UAlberta-EcoCar/Fuel-Cell-Controller-2017-2018/Fuel_Cell_Controller.brd

## EAGLE design Fuel_Cell_Controller.brd (2018-07-14)

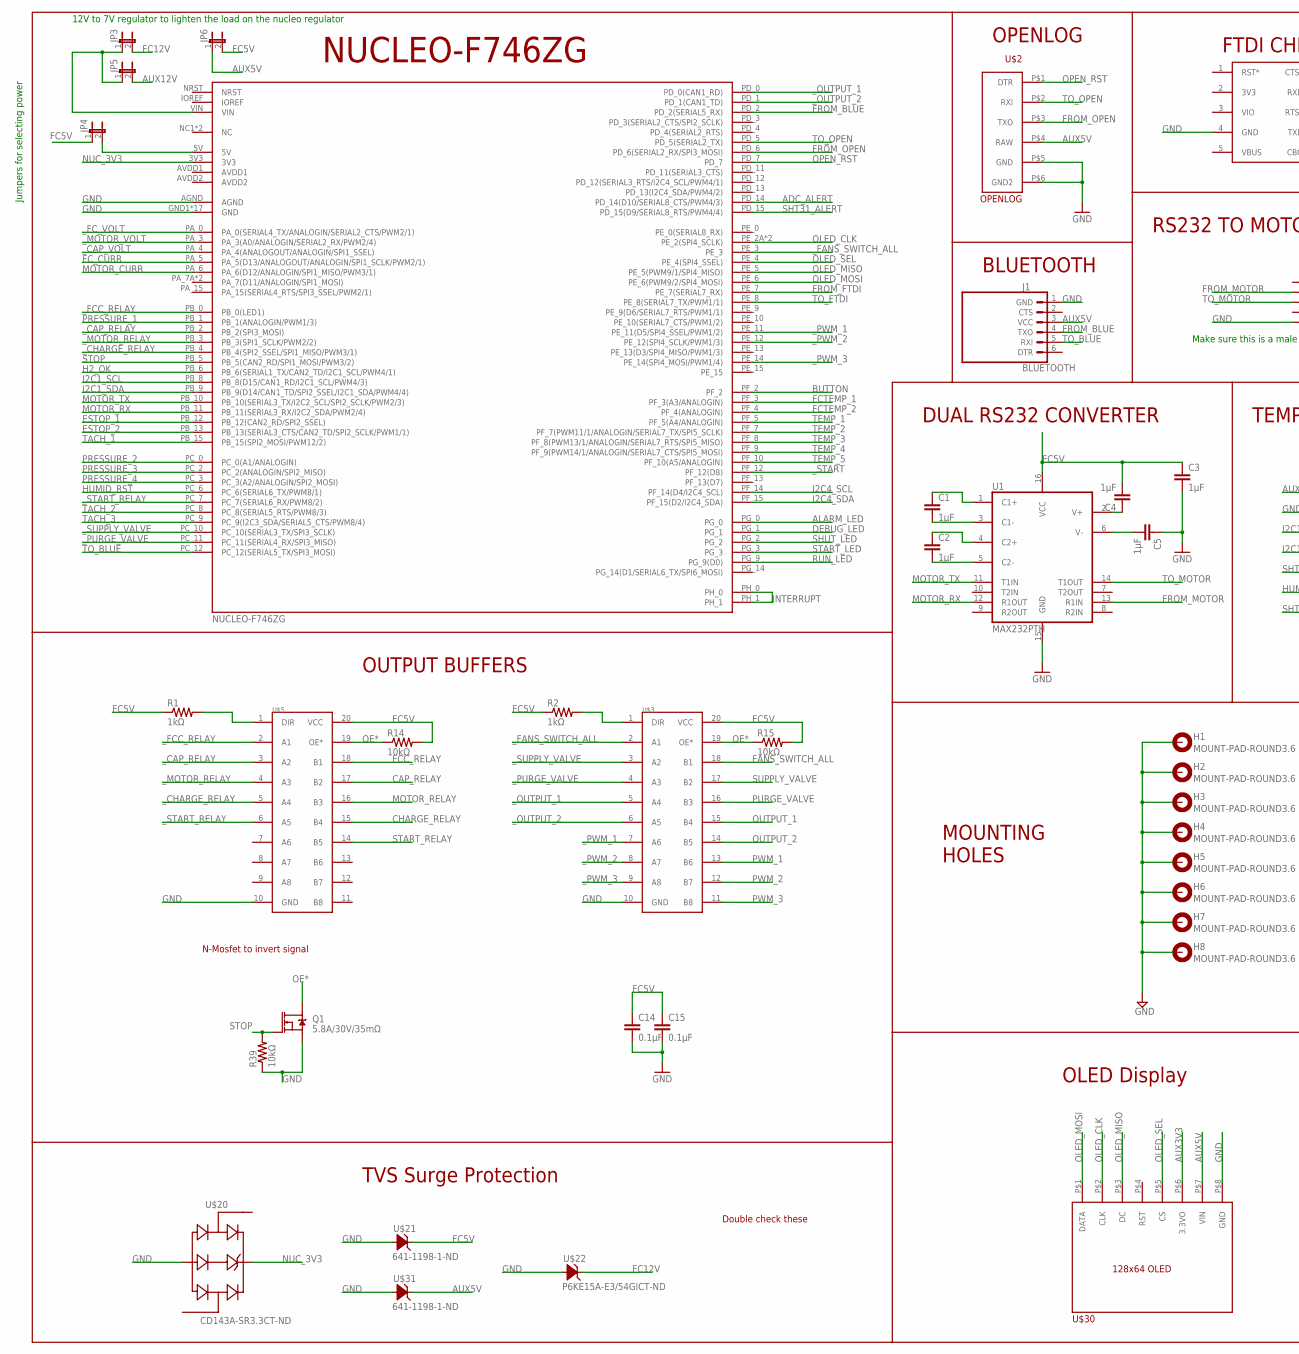
[picture p1: schematic Fuel_Cell_Controller.sch, sheet 1, MCU, part in row 1, column 1]

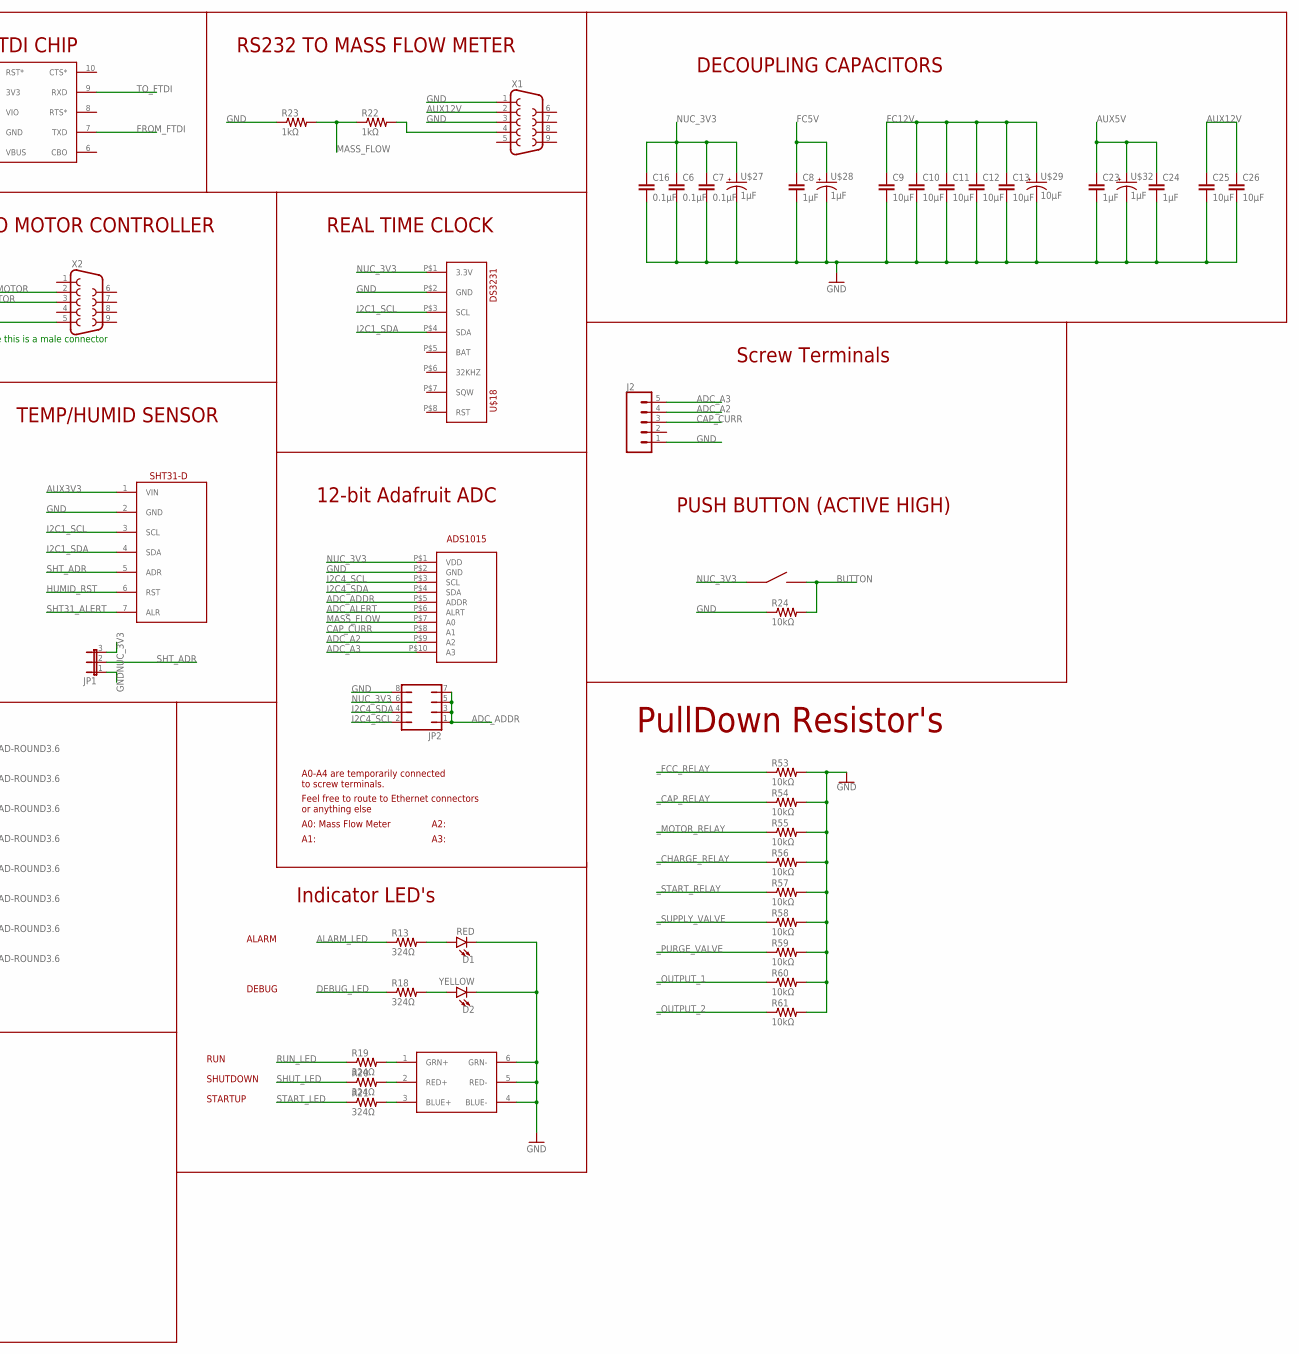
[picture p2: schematic Fuel_Cell_Controller.sch, sheet 1, MCU, part in row 1, column 2]

Parts:
C1, C2, C3, C4, C5, C8, C23, C24: 1µF; 0805
C6, C7, C14, C15, C16: 0.1µF; 0805
C9, C10, C11, C12, C13, C25, C26: 10µF; 0805
D1: RED; LED-1206
D2: YELLOW; LED-1206
H1, H2, H3, H4, H5, H6, H7, H8: MOUNT-PAD-ROUND3.6; 3,6-PAD
J1: BLUETOOTH; 1X06BLUETOOTH
J2: CONN_05SCREW; SCREWTERMINAL-3.5MM-5
JP1: JP2E; JP2
JP2: JP4Q
JP3, JP4, JP5, JP6: JP1E; JP1
Q1: 5.8A/30V/35mΩ; SOT23-3
R1, R2, R22, R23: 1kΩ; 0805
R13, R18, R19, R20, R21: 324Ω; 0805
R14, R15, R24, R39, R53, R54, R55, R56, R57, R58, R59, R60, R61: 10kΩ; 0805
SHTSENSOR: SHT31-DIS; 1X07-SHT31-DIS
U1: MAX232PTH; DIL16
U$1: NUCLEO-F746ZGNUCLEO-F746ZG; NUCLEO-F746ZG
U$2: OPENLOG
U$3, U$5: SN74LVC245AN; DIL20
U$10: UMFT234XF
U$18: DS3231
U$19: ADS1015
U$20: CD143A-SR3.3CT-ND; SOT143_AVAGO
U$21, U$31: 641-1198-1-ND; SOT23
U$22: P6KE15A-E3/54GICT-ND; DO-204AC
U$25: 5060BRG45060BRG4; 5060BRG4
U$26: EG4621CT-ND
U$27, U$28, U$32: 1µF; PANASONIC_D
U$29: 10µF; PANASONIC_D
U$30: ADAFRUITOLED; 1X08OLED
X1, X2: F09HP

Connections:
ADC_A2: J2.4, U$19.P$9 (A2)
ADC_A3: J2.5, U$19.P$10 (A3)
ADC_ADDR: JP2.1, JP2.3, JP2.5, JP2.7, U$19.P$5 (ADDR)
ADC_ALERT: U$1.PD_14 (PD_14(D10/SERIAL8_CTS/PWM4/3)), U$19.P$6 (ALRT)
ALARM_LED: R13.1, U$1.PG_0
AUX3V3: SHTSENSOR.1 (VIN), U$30.P$6 (3.3VO)
AUX5V: C23.1, C24.1, J1.3 (VCC), JP6.1, U$2.P$4 (RAW), U$30.P$7 (VIN), U$31.C, U$32.+; also elsewhere on the board
AUX12V: C25.1, C26.1, JP5.2, X1.2; also elsewhere on the board
BUTTON: R24.2, U$1.PF_2, U$26.P$3, U$26.P$4
CAP_CURR: J2.3, U$19.P$8 (A1); also elsewhere on the board
CAP_RELAY: U$5.17 (B2); also elsewhere on the board
CHARGE_RELAY: U$5.15 (B4); also elsewhere on the board
DEBUG_LED: R18.1, U$1.PG_1
ESTOP_1: U$1.PB_12 (PB_12(CAN2_RD/SPI2_SSEL)); also elsewhere on the board
ESTOP_2: U$1.PB_13 (PB_13(SERIAL3_CTS/CAN2_TD/SPI2_SCLK/PWM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); also elsewhere on the board
FANS_SWITCH_ALL: U$3.18 (B1); also elsewhere on the board
FC5V: C3.1, C4.2, C8.1, C14.1, C15.1, JP4.1, JP6.2, R1.1, R2.1, R14.2, R15.2, U1.16 (VCC), U$3.20 (VCC), U$5.20 (VCC), U$21.C, U$28.+; also elsewhere on the board
FC12V: C9.1, C10.1, C11.1, C12.1, C13.1, JP3.2, U$22.CATHODE (C), U$29.+; also elsewhere on the board
FCC_RELAY: U$5.18 (B1); also elsewhere on the board
FCTEMP_1: U$1.PF_3 (PF_3(A3/ANALOGIN)); also elsewhere on the board
FCTEMP_2: U$1.PF_4 (PF_4(ANALOGIN)); also elsewhere on the board
FC_CURR: U$1.PA_5 (PA_5(D13/ANALOGOUT/ANALOGIN/SPI1_SCLK/P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); also elsewhere on the board
FROM_BLUE: J1.4 (TXO), U$1.PD_2 (PD_2(SERIAL5_RX))
FROM_FTDI: U$1.PE_7 (PE_7(SERIAL7_RX)), U$10.7 (TXD)
FROM_MOTOR: U1.13 (R1IN), X2.2
FROM_OPEN: U$1.PD_6 (PD_6(SERIAL2_RX/SPI3_MOSI)), U$2.P$3 (TXO)
GND: C3.2, C5.1, C6.2, C7.2, C8.2, C9.2, C10.2, C11.2, C12.2, C13.2, C14.2, C15.2, C16.2, C23.2, C24.2, C25.2, C26.2, D1.C, D2.C, H1.B3,6, H2.B3,6, H3.B3,6, H4.B3,6, H5.B3,6, H6.B3,6, H7.B3,6, H8.B3,6, J1.1 (GND), J2.1, JP1.1, JP2.8, Q1.2 (S), R23.1, R24.1, R39.1, R53.2, R54.2, R55.2, R56.2, R57.2, R58.2, R59.2, R60.2, R61.2, SHTSENSOR.2 (GND), U1.15 (GND), U$1.AGND, U$1.GND1 (GND), U$1.GND2 (GND), U$1.GND3 (GND), U$1.GND4 (GND), U$1.GND5 (GND), U$1.GND6 (GND), U$1.GND7 (GND), U$1.GND8 (GND), U$1.GND9 (GND), U$1.GND10 (GND), U$1.GND11 (GND), U$1.GND12 (GND), U$1.GND13 (GND), U$1.GND14 (GND), U$1.GND15 (GND), U$1.GND16 (GND), U$1.GND17 (GND), U$2.P$5 (GND), U$2.P$6 (GND2), U$3.10 (GND), U$5.10 (GND), U$10.4 (GND), U$18.P$2 (GND), U$19.P$2 (GND), U$20.GND, U$21.A1 (A), U$21.A2 (A), U$22.ANODE (A), U$25.4 (BLUE-), U$25.5 (RED-), U$25.6 (GRN-), U$27.-, U$28.-, U$29.-, U$30.P$8 (GND), U$31.A1 (A), U$31.A2 (A), U$32.-, X1.1, X1.3, X2.5; also elsewhere on the board
H2_OK: U$1.PB_6 (PB_6(SERIAL1_TX/CAN2_TD/I2C1_SCL/PWM4/1)); also elsewhere on the board
HUMID_RST: SHTSENSOR.6 (RST), U$1.PC_6 (PC_6(SERIAL6_TX/PWM8/1))
I2C1_SCL: SHTSENSOR.3 (SCL), U$1.PB_8 (PB_8(D15/CAN1_RD/I2C1_SCL/PWM4/3)), U$18.P$3 (SCL)
I2C1_SDA: SHTSENSOR.4 (SDA), U$1.PB_9 (PB_9(D14/CAN1_TD/SPI2_SSEL/I2C1_SDA/PWM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), U$18.P$4 (SDA)
I2C4_SCL: JP2.2, U$1.PF_14 (PF_14(D4/I2C4_SCL)), U$19.P$3 (SCL)
I2C4_SDA: JP2.4, U$1.PF_15 (PF_15(D2/I2C4_SDA)), U$19.P$4 (SDA)
INTERRUPT: U$1.PH_0, U$1.PH_1
MASS_FLOW: R22.1, R23.2, U$19.P$7 (A0)
MOTOR_CURR: U$1.PA_6 (PA_6(D12/ANALOGIN/SPI1_MISO/PWM3/1)); also elsewhere on the board
MOTOR_RELAY: U$5.16 (B3); also elsewhere on the board
MOTOR_RX: U1.12 (R1OUT), U$1.PB_11 (PB_11(SERIAL3_RX/I2C2_SDA/PWM2/4))
MOTOR_TX: U1.11 (T1IN), U$1.PB_10 (PB_10(SERIAL3_TX/I2C2_SCL/SPI2_SCLK/PWM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)
unnamed: JP4.2, U$1.5V
unnamed: C1.1, U1.1 (C1+)
unnamed: C1.2, U1.3 (C1-)
unnamed: C2.1, U1.4 (C2+)
unnamed: C2.2, U1.5 (C2-)
unnamed: C4.1, U1.2 (V+)
unnamed: C5.2, U1.6 (V-)
unnamed: R2.2, U$3.1 (DIR)
unnamed: R1.2, U$5.1 (DIR)
unnamed: R22.2, X1.4
unnamed: D1.A, R13.2
unnamed: D2.A, R18.2
unnamed: R19.2, U$25.1 (GRN+)
unnamed: R20.2, U$25.2 (RED+)
unnamed: R21.2, U$25.3 (BLUE+)
NUC_3V3: C6.1, C7.1, C16.1, JP1.3, JP2.6, U$1.3V3, U$18.P$1 (3.3V), U$19.P$1 (VDD), U$20.VDD, U$26.P$1, U$26.P$2, U$27.+; also elsewhere on the board
OE*: Q1.3 (D), R14.1, R15.1, U$3.19 (OE*), U$5.19 (OE*)
OLED_CLK: U$1.PE_2A (PE_2(SPI4_SCLK)), U$1.PE_2B (PE_2(SPI4_SCLK)), U$30.P$2 (CLK)
OLED_MISO: U$1.PE_5 (PE_5(PWM9/1/SPI4_MISO)), U$30.P$3 (DC)
OLED_MOSI: U$1.PE_6 (PE_6(PWM9/2/SPI4_MOSI)), U$30.P$1 (DATA)
OLED_SEL: U$1.PE_4 (PE_4(SPI4_SSEL)), U$30.P$5 (CS)
OPEN_RST: U$1.PD_7, U$2.P$1 (DTR)
OUTPUT_1: U$3.15 (B4); also elsewhere on the board
OUTPUT_2: U$3.14 (B5); also elsewhere on the board
PRESSURE_1: U$1.PB_1 (PB_1(ANALOGIN/PWM1/3)); also elsewhere on the board
PRESSURE_2: U$1.PC_0 (PC_0(A1/ANALOGIN)); also elsewhere on the board
PRESSURE_3: U$1.PC_2 (PC_2(ANALOGIN/SPI2_MISO)); also elsewhere on the board
PRESSURE_4: U$1.PC_3 (PC_3(A2/ANALOGIN/SPI2_MOSI)); also elsewhere on the board
PURGE_VALVE: U$3.16 (B3); also elsewhere on the board
PWM_1: U$3.13 (B6); also elsewhere on the board
PWM_2: U$3.12 (B7); also elsewhere on the board
PWM_3: U$3.11 (B8); also elsewhere on the board
RUN_LED: R19.1, U$1.PG_9 (PG_9(D0))
SHT31_ALERT: SHTSENSOR.7 (ALR), U$1.PD_15 (PD_15(D9/SERIAL8_RTS/PWM4/4))
SHT_ADR: JP1.2, SHTSENSOR.5 (ADR)
SHUT_LED: R20.1, U$1.PG_2
START_LED: R21.1, U$1.PG_3
START_RELAY: U$5.14 (B5); also elsewhere on the board
STOP: Q1.1 (G), R39.2, U$1.PB_5 (PB_5(CAN2_RD/SPI1_MOSI/PWM3/2)); also elsewhere on the board
SUPPLY_VALVE: U$3.17 (B2); also elsewhere on the board
TACH_1: U$1.PB_15 (PB_15(SPI2_MOSI/PWM12/2)); also elsewhere on the board
TACH_2: U$1.PC_8 (PC_8(SERIAL5_RTS/PWM8/3)); also elsewhere on the board
TACH_3: U$1.PC_9 (PC_9(I2C3_SDA/SERIAL5_CTS/PWM8/4)); also elsewhere on the board
TEMP_1: U$1.PF_5 (PF_5(A4/ANALOGIN)); also elsewhere on the board
TEMP_2: U$1.PF_7 (PF_7(PWM11/1/ANALOGIN/SERIAL7_TX/SPI5_S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); also elsewhere on the board
TEMP_3: U$1.PF_8 (PF_8(PWM13/1/ANALOGIN/SERIAL7_RTS/SPI5_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); also elsewhere on the board
TEMP_4: U$1.PF_9 (PF_9(PWM14/1/ANALOGIN/SERIAL7_CTS/SPI5_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); also elsewhere on the board
TEMP_5: U$1.PF_10 (PF_10(A5/ANALOGIN)); also elsewhere on the board
TO_BLUE: J1.5 (RXI), U$1.PC_12 (PC_12(SERIAL5_TX/SPI3_MOSI))
TO_FTDI: U$1.PE_8 (PE_8(SERIAL7_TX/PWM1/1)), U$10.9 (RXD)
TO_MOTOR: U1.14 (T1OUT), X2.3
TO_OPEN: U$1.PD_5 (PD_5(SERIAL2_TX)), U$2.P$2 (RXI)
VIN: JP3.1, JP5.1, U$1.VIN
_CAP_RELAY: R54.1, U$1.PB_2 (PB_2(SPI3_MOSI)), U$5.3 (A2)
_CAP_VOLT: U$1.PA_4 (PA_4(ANALOGOUT/ANALOGIN/SPI1_SSEL)); also elsewhere on the board
_CHARGE_RELAY: R56.1, U$1.PB_4 (PB_4(SPI2_SSEL/SPI1_MISO/PWM3/1)), U$5.5 (A4)
_FANS_SWITCH_ALL: U$1.PE_3, U$3.2 (A1)
_FCC_RELAY: R53.1, U$1.PB_0 (PB_0(LED1)), U$5.2 (A1)
_FC_VOLT: U$1.PA_0 (PA_0(SERIAL4_TX/ANALOGIN/SERIAL2_CTS/PW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); also elsewhere on the board
_MOTOR_RELAY: R55.1, U$1.PB_3 (PB_3(SPI1_SCLK/PWM2/2)), U$5.4 (A3)
_MOTOR_VOLT: U$1.PA_3 (PA_3(A0/ANALOGIN/SERIAL2_RX/PWM2/4)); also elsewhere on the board
_OUTPUT_1: R60.1, U$1.PD_0 (PD_0(CAN1_RD)), U$3.5 (A4)
_OUTPUT_2: R61.1, U$1.PD_1 (PD_1(CAN1_TD)), U$3.6 (A5)
_PURGE_VALVE: R59.1, U$1.PC_11 (PC_11(SERIAL4_RX/SPI3_MISO)), U$3.4 (A3)
_PWM_1: U$1.PE_11 (PE_11(D5/SPI4_SSEL/PWM1/2)), U$3.7 (A6)
_PWM_2: U$1.PE_12 (PE_12(SPI4_SCLK/PWM1/3)), U$3.8 (A7)
_PWM_3: U$1.PE_14 (PE_14(SPI4_MOSI/PWM1/4)), U$3.9 (A8)
_START: U$1.PF_12 (PF_12(D8)); also elsewhere on the board
_START_RELAY: R57.1, U$1.PC_7 (PC_7(SERIAL6_RX/PWM8/2)), U$5.6 (A5)
_SUPPLY_VALVE: R58.1, U$1.PC_10 (PC_10(SERIAL3_TX/SPI3_SCLK)), U$3.3 (A2)

Notes on the sheet:
NUCLEO-F746ZG
OPENLOG
BLUETOOTH
DUAL RS232 CONVERTER
RS232 TO MOTOR CONTROLLER
FTDI CHIP
TEMP/HUMID SENSOR
RS232 TO MASS FLOW METER
REAL TIME CLOCK
OUTPUT BUFFERS
12-bit Adafruit ADC
A0-A4 are temporarily connected to screw terminals.
Feel free to route to Ethernet connectors or anything else
A0: Mass Flow Meter
A1:
A2:
A3:
MOUNTING HOLES
Indicator LED's
TVS Surge Protection
DECOUPLING CAPACITORS
ALARM
Double check these
Screw Terminals
DEBUG
RUN
SHUTDOWN
STARTUP
PUSH BUTTON (ACTIVE HIGH)
OLED Display
N-Mosfet to invert signal
Jumpers for selecting power
12V to 7V regulator to lighten the load on the nucleo regulator
Make sure this is a male connector
PullDown Resistor's

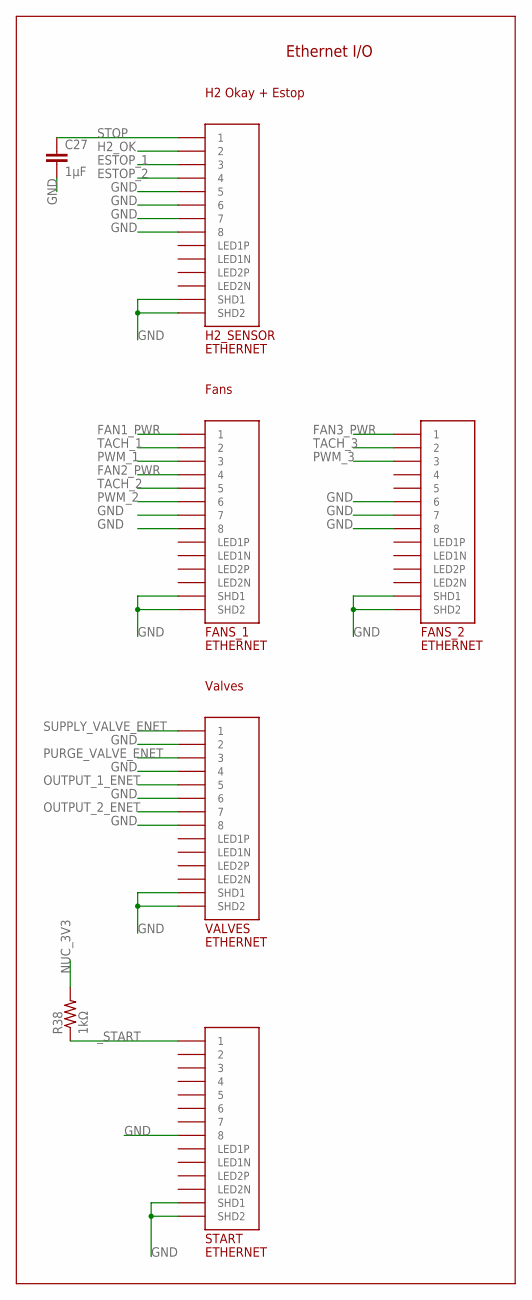
[picture p3: schematic Fuel_Cell_Controller.sch, sheet 2, Ethernet I/O]

Parts:
C27: 1µF; 0805
FANS_1, FANS_2: ETHERNET; A122645-ND
H2_SENSOR: ETHERNET; A122645-ND
R38: 1kΩ; 0805
START: ETHERNET; A122645-ND
VALVES: ETHERNET; A122645-ND

Connections:
ESTOP_1: H2_SENSOR.P$3 (3); also elsewhere on the board
ESTOP_2: H2_SENSOR.P$4 (4); also elsewhere on the board
FAN1_PWR: FANS_1.P$1 (1); also elsewhere on the board
FAN2_PWR: FANS_1.P$4 (4); also elsewhere on the board
FAN3_PWR: FANS_2.P$1 (1); also elsewhere on the board
GND: C27.2, FANS_1.P$7 (7), FANS_1.P$8 (8), FANS_1.P$13 (SHD1), FANS_1.P$14 (SHD2), FANS_2.P$6 (6), FANS_2.P$7 (7), FANS_2.P$8 (8), FANS_2.P$13 (SHD1), FANS_2.P$14 (SHD2), H2_SENSOR.P$5 (5), H2_SENSOR.P$6 (6), H2_SENSOR.P$7 (7), H2_SENSOR.P$8 (8), H2_SENSOR.P$13 (SHD1), H2_SENSOR.P$14 (SHD2), START.P$8 (8), START.P$13 (SHD1), START.P$14 (SHD2), VALVES.P$2 (2), VALVES.P$4 (4), VALVES.P$6 (6), VALVES.P$8 (8), VALVES.P$13 (SHD1), VALVES.P$14 (SHD2); also elsewhere on the board
H2_OK: H2_SENSOR.P$2 (2); also elsewhere on the board
NUC_3V3: R38.2; also elsewhere on the board
OUTPUT_1_ENET: VALVES.P$5 (5); also elsewhere on the board
OUTPUT_2_ENET: VALVES.P$7 (7); also elsewhere on the board
PURGE_VALVE_ENET: VALVES.P$3 (3); also elsewhere on the board
PWM_1: FANS_1.P$3 (3); also elsewhere on the board
PWM_2: FANS_1.P$6 (6); also elsewhere on the board
PWM_3: FANS_2.P$3 (3); also elsewhere on the board
STOP: C27.1, H2_SENSOR.P$1 (1); also elsewhere on the board
SUPPLY_VALVE_ENET: VALVES.P$1 (1); also elsewhere on the board
TACH_1: FANS_1.P$2 (2); also elsewhere on the board
TACH_2: FANS_1.P$5 (5); also elsewhere on the board
TACH_3: FANS_2.P$2 (2); also elsewhere on the board
_START: R38.1, START.P$1 (1); also elsewhere on the board

Notes on the sheet:
Ethernet I/O
Fans
Valves
H2 Okay + Estop

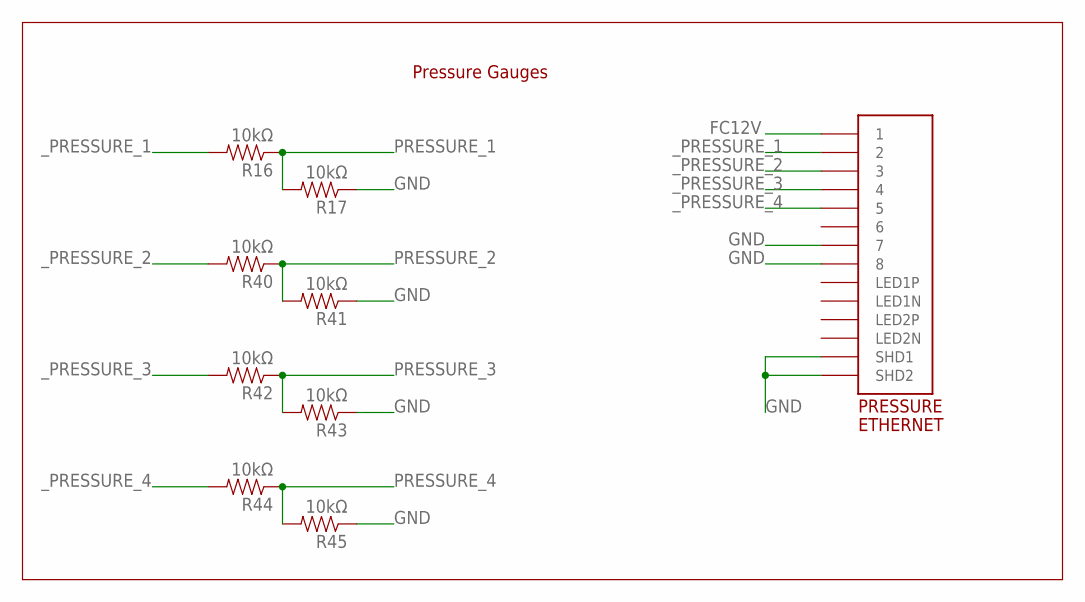
[picture p4: schematic Fuel_Cell_Controller.sch, sheet 3]

Parts:
PRESSURE: ETHERNET; A122645-ND
R16, R17, R40, R41, R42, R43, R44, R45: 10kΩ; 0805

Connections:
FC12V: PRESSURE.P$1 (1); also elsewhere on the board
GND: PRESSURE.P$7 (7), PRESSURE.P$8 (8), PRESSURE.P$13 (SHD1), PRESSURE.P$14 (SHD2), R17.1, R41.1, R43.1, R45.1; also elsewhere on the board
PRESSURE_1: R16.1, R17.2; also elsewhere on the board
PRESSURE_2: R40.1, R41.2; also elsewhere on the board
PRESSURE_3: R42.1, R43.2; also elsewhere on the board
PRESSURE_4: R44.1, R45.2; also elsewhere on the board
_PRESSURE_1: PRESSURE.P$2 (2), R16.2
_PRESSURE_2: PRESSURE.P$3 (3), R40.2
_PRESSURE_3: PRESSURE.P$4 (4), R42.2
_PRESSURE_4: PRESSURE.P$5 (5), R44.2

Notes on the sheet:
Pressure Gauges

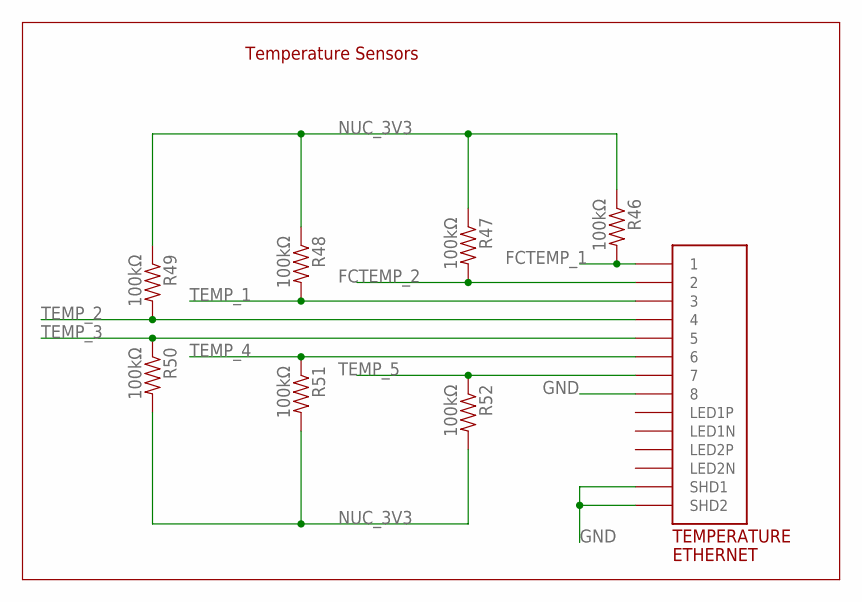
[picture p5: schematic Fuel_Cell_Controller.sch, sheet 4]

Parts:
R46, R47, R48, R49, R50, R51, R52: 100kΩ; 0805
TEMPERATURE: ETHERNET; A122645-ND

Connections:
FCTEMP_1: R46.2, TEMPERATURE.P$1 (1); also elsewhere on the board
FCTEMP_2: R47.2, TEMPERATURE.P$2 (2); also elsewhere on the board
GND: TEMPERATURE.P$8 (8), TEMPERATURE.P$13 (SHD1), TEMPERATURE.P$14 (SHD2); also elsewhere on the board
NUC_3V3: R46.1, R47.1, R48.1, R49.1, R50.2, R51.2, R52.2; also elsewhere on the board
TEMP_1: R48.2, TEMPERATURE.P$3 (3); also elsewhere on the board
TEMP_2: R49.2, TEMPERATURE.P$4 (4); also elsewhere on the board
TEMP_3: R50.1, TEMPERATURE.P$5 (5); also elsewhere on the board
TEMP_4: R51.1, TEMPERATURE.P$6 (6); also elsewhere on the board
TEMP_5: R52.1, TEMPERATURE.P$7 (7); also elsewhere on the board

Notes on the sheet:
Temperature Sensors

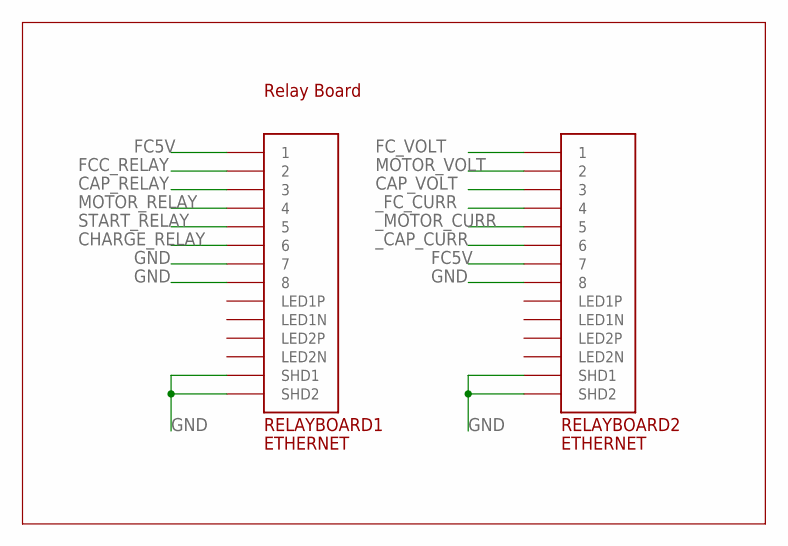
[picture p6: schematic Fuel_Cell_Controller.sch, sheet 5, RELAY BOARD Ethernet]

Parts:
RELAYBOARD1, RELAYBOARD2: ETHERNET; A122645-ND

Connections:
CAP_RELAY: RELAYBOARD1.P$3 (3); also elsewhere on the board
CAP_VOLT: RELAYBOARD2.P$3 (3); also elsewhere on the board
CHARGE_RELAY: RELAYBOARD1.P$6 (6); also elsewhere on the board
FC5V: RELAYBOARD1.P$1 (1), RELAYBOARD2.P$7 (7); also elsewhere on the board
FCC_RELAY: RELAYBOARD1.P$2 (2); also elsewhere on the board
FC_VOLT: RELAYBOARD2.P$1 (1); also elsewhere on the board
GND: RELAYBOARD1.P$7 (7), RELAYBOARD1.P$8 (8), RELAYBOARD1.P$13 (SHD1), RELAYBOARD1.P$14 (SHD2), RELAYBOARD2.P$8 (8), RELAYBOARD2.P$13 (SHD1), RELAYBOARD2.P$14 (SHD2); also elsewhere on the board
MOTOR_RELAY: RELAYBOARD1.P$4 (4); also elsewhere on the board
MOTOR_VOLT: RELAYBOARD2.P$2 (2); also elsewhere on the board
START_RELAY: RELAYBOARD1.P$5 (5); also elsewhere on the board
_CAP_CURR: RELAYBOARD2.P$6 (6); also elsewhere on the board
_FC_CURR: RELAYBOARD2.P$4 (4); also elsewhere on the board
_MOTOR_CURR: RELAYBOARD2.P$5 (5); also elsewhere on the board

Notes on the sheet:
Relay Board

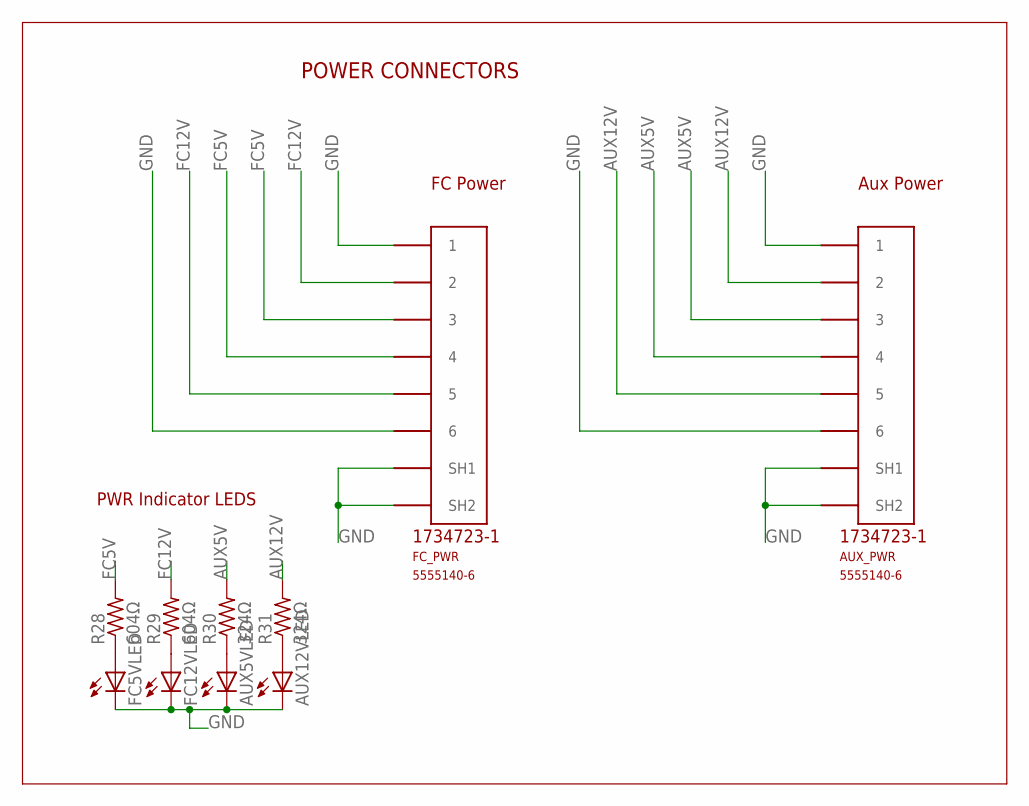
[picture p7: schematic Fuel_Cell_Controller.sch, sheet 6, POWER Inputs]

Parts:
AUX5VLED, AUX12VLED: LEDCHIP-LED0805; CHIP-LED0805
AUX_PWR: 5555140-6; 1734723-1_RJ11
FC5VLED, FC12VLED: LEDCHIP-LED0805; CHIP-LED0805
FC_PWR: 5555140-6; 1734723-1_RJ11
R28, R29: 604Ω; R0805
R30, R31: 324Ω; R0805

Connections:
AUX5V: AUX_PWR.3, AUX_PWR.4, R30.2; also elsewhere on the board
AUX12V: AUX_PWR.2, AUX_PWR.5, R31.2; also elsewhere on the board
FC5V: FC_PWR.3, FC_PWR.4, R28.2; also elsewhere on the board
FC12V: FC_PWR.2, FC_PWR.5, R29.2; also elsewhere on the board
GND: AUX5VLED.C, AUX12VLED.C, AUX_PWR.1, AUX_PWR.6, AUX_PWR.SH1, AUX_PWR.SH2, FC5VLED.C, FC12VLED.C, FC_PWR.1, FC_PWR.6, FC_PWR.SH1, FC_PWR.SH2; also elsewhere on the board
unnamed: FC5VLED.A, R28.1
unnamed: FC12VLED.A, R29.1
unnamed: AUX5VLED.A, R30.1
unnamed: AUX12VLED.A, R31.1

Notes on the sheet:
FC Power
Aux Power
POWER CONNECTORS
PWR Indicator LEDS

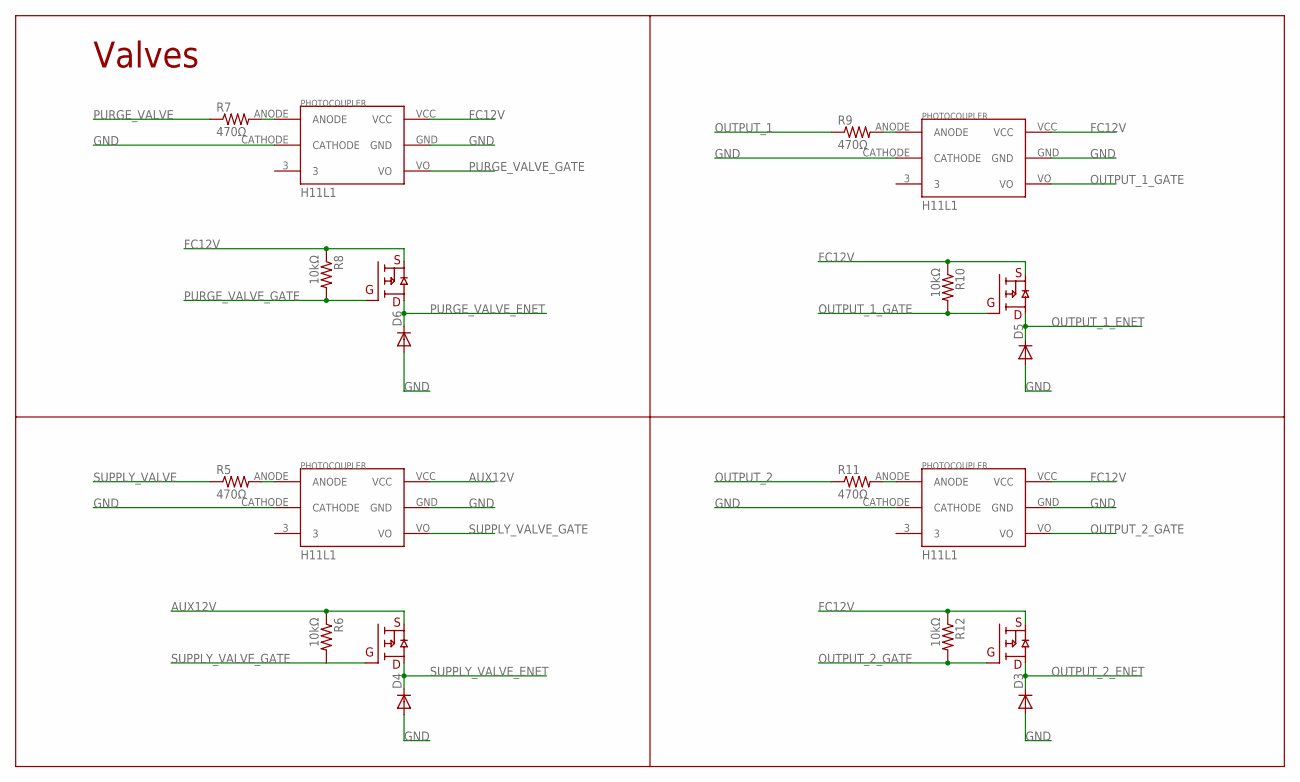
[picture p8: schematic Fuel_Cell_Controller.sch, sheet 7, VALVES]

Parts:
D3, D4, D5, D6: DIODE-DO214AC; DO214AC
R5, R7, R9, R11: 470Ω; 0805
R6, R8, R10, R12: 10kΩ; 0805
U$6, U$11, U$14, U$16: H11L1H11L1; H11L1
U$12, U$13, U$15, U$17: DMP3056L-7DMP3056L-7; DMP3056L-7

Connections:
AUX12V: R6.1, U$6.VCC, U$12.S (SOURCE); also elsewhere on the board
FC12V: R8.1, R10.1, R12.1, U$11.VCC, U$13.S (SOURCE), U$14.VCC, U$15.S (SOURCE), U$16.VCC, U$17.S (SOURCE); also elsewhere on the board
GND: D3.A, D4.A, D5.A, D6.A, U$6.CATHODE, U$6.GND, U$11.CATHODE, U$11.GND, U$14.CATHODE, U$14.GND, U$16.CATHODE, U$16.GND; also elsewhere on the board
unnamed: R5.2, U$6.ANODE
unnamed: R7.2, U$11.ANODE
unnamed: R9.2, U$14.ANODE
unnamed: R11.2, U$16.ANODE
OUTPUT_1: R9.1; also elsewhere on the board
OUTPUT_1_ENET: D5.C, U$15.D (DRAIN); also elsewhere on the board
OUTPUT_1_GATE: R10.2, U$14.VO, U$15.G (GATE)
OUTPUT_2: R11.1; also elsewhere on the board
OUTPUT_2_ENET: D3.C, U$17.D (DRAIN); also elsewhere on the board
OUTPUT_2_GATE: R12.2, U$16.VO, U$17.G (GATE)
PURGE_VALVE: R7.1; also elsewhere on the board
PURGE_VALVE_ENET: D6.C, U$13.D (DRAIN); also elsewhere on the board
PURGE_VALVE_GATE: R8.2, U$11.VO, U$13.G (GATE)
SUPPLY_VALVE: R5.1; also elsewhere on the board
SUPPLY_VALVE_ENET: D4.C, U$12.D (DRAIN); also elsewhere on the board
SUPPLY_VALVE_GATE: R6.2, U$6.VO, U$12.G (GATE)

Notes on the sheet:
Valves

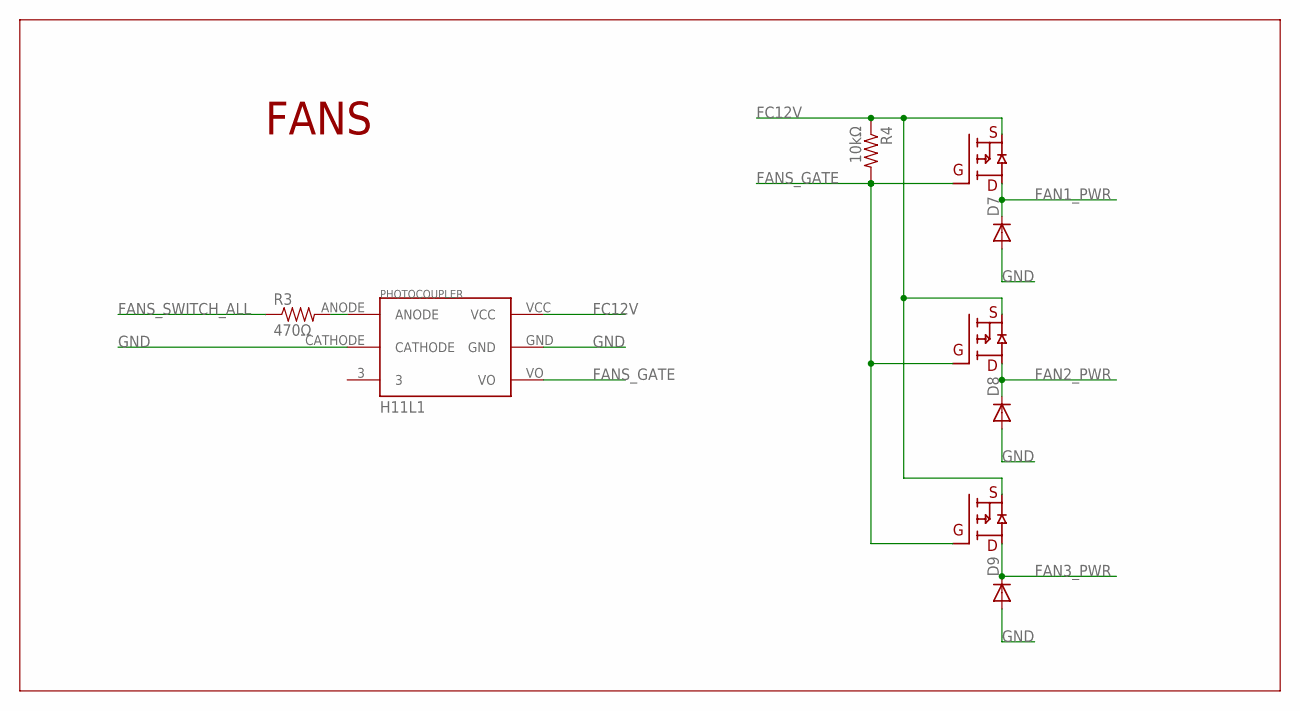
[picture p9: schematic Fuel_Cell_Controller.sch, sheet 8, Fans]

Parts:
D7, D8, D9: DIODE-DO214AC; DO214AC
R3: 470Ω; 0805
R4: 10kΩ; 0805
U$4: H11L1H11L1; H11L1
U$7, U$8, U$9: DMP3056L-7DMP3056L-7; DMP3056L-7

Connections:
FAN1_PWR: D7.C, U$7.D (DRAIN); also elsewhere on the board
FAN2_PWR: D8.C, U$8.D (DRAIN); also elsewhere on the board
FAN3_PWR: D9.C, U$9.D (DRAIN); also elsewhere on the board
FANS_GATE: R4.2, U$4.VO, U$7.G (GATE), U$8.G (GATE), U$9.G (GATE)
FANS_SWITCH_ALL: R3.1; also elsewhere on the board
FC12V: R4.1, U$4.VCC, U$7.S (SOURCE), U$8.S (SOURCE), U$9.S (SOURCE); also elsewhere on the board
GND: D7.A, D8.A, D9.A, U$4.CATHODE, U$4.GND; also elsewhere on the board
unnamed: R3.2, U$4.ANODE

Notes on the sheet:
FANS

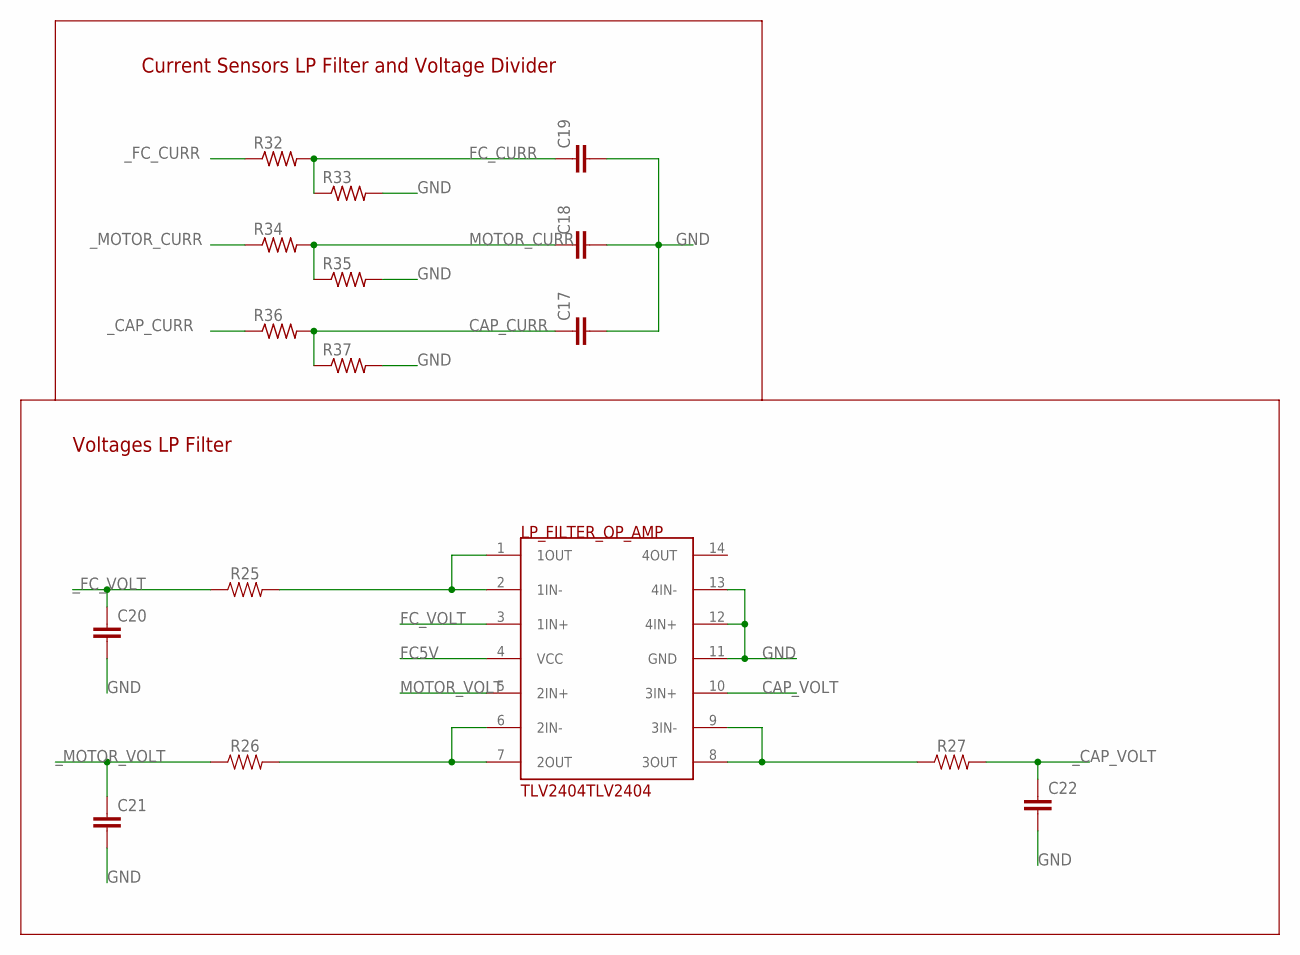
[picture p10: schematic Fuel_Cell_Controller.sch, sheet 9, FC LP FILTER]

Parts:
C17, C18, C19, C20, C21, C22: CAP0805; 0805
LP_FILTER_OP_AMP: TLV2404TLV2404; DIL14
R25, R26, R27: 0402
R32, R33, R34, R35, R36, R37: R-US_R0805; R0805

Connections:
CAP_CURR: C17.1, R36.2, R37.1; also elsewhere on the board
CAP_VOLT: LP_FILTER_OP_AMP.10 (3IN+); also elsewhere on the board
FC5V: LP_FILTER_OP_AMP.4 (VCC); also elsewhere on the board
FC_CURR: C19.1, R32.2, R33.1; also elsewhere on the board
FC_VOLT: LP_FILTER_OP_AMP.3 (1IN+); also elsewhere on the board
GND: C17.2, C18.2, C19.2, C20.2, C21.2, C22.2, LP_FILTER_OP_AMP.11 (GND), LP_FILTER_OP_AMP.12 (4IN+), LP_FILTER_OP_AMP.13 (4IN-), R33.2, R35.2, R37.2; also elsewhere on the board
MOTOR_CURR: C18.1, R34.2, R35.1; also elsewhere on the board
MOTOR_VOLT: LP_FILTER_OP_AMP.5 (2IN+); also elsewhere on the board
unnamed: LP_FILTER_OP_AMP.1 (1OUT), LP_FILTER_OP_AMP.2 (1IN-), R25.2
unnamed: LP_FILTER_OP_AMP.6 (2IN-), LP_FILTER_OP_AMP.7 (2OUT), R26.2
unnamed: LP_FILTER_OP_AMP.8 (3OUT), LP_FILTER_OP_AMP.9 (3IN-), R27.1
_CAP_CURR: R36.1; also elsewhere on the board
_CAP_VOLT: C22.1, R27.2; also elsewhere on the board
_FC_CURR: R32.1; also elsewhere on the board
_FC_VOLT: C20.1, R25.1; also elsewhere on the board
_MOTOR_CURR: R34.1; also elsewhere on the board
_MOTOR_VOLT: C21.1, R26.1; also elsewhere on the board

Notes on the sheet:
Current Sensors LP Filter and Voltage Divider
Voltages LP Filter
