UAlberta-EcoCar/Fuel-Cell-Controller-2017-2018/Fuel_Cell_Controller.brd

## EAGLE design Fuel_Cell_Controller.brd (continued)

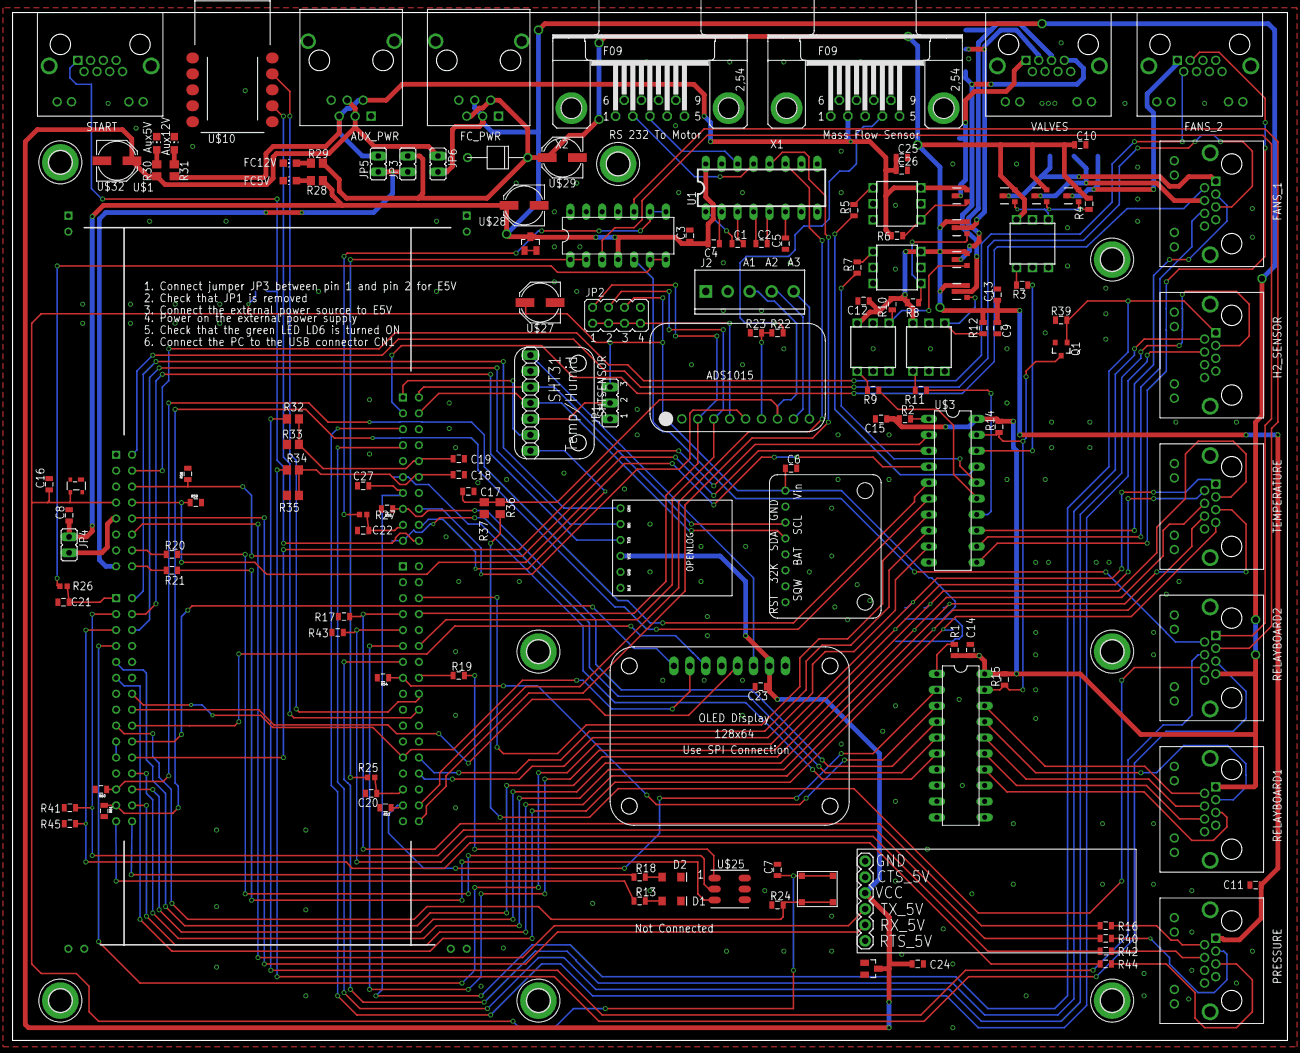
[picture p11: board Fuel_Cell_Controller.brd from above]

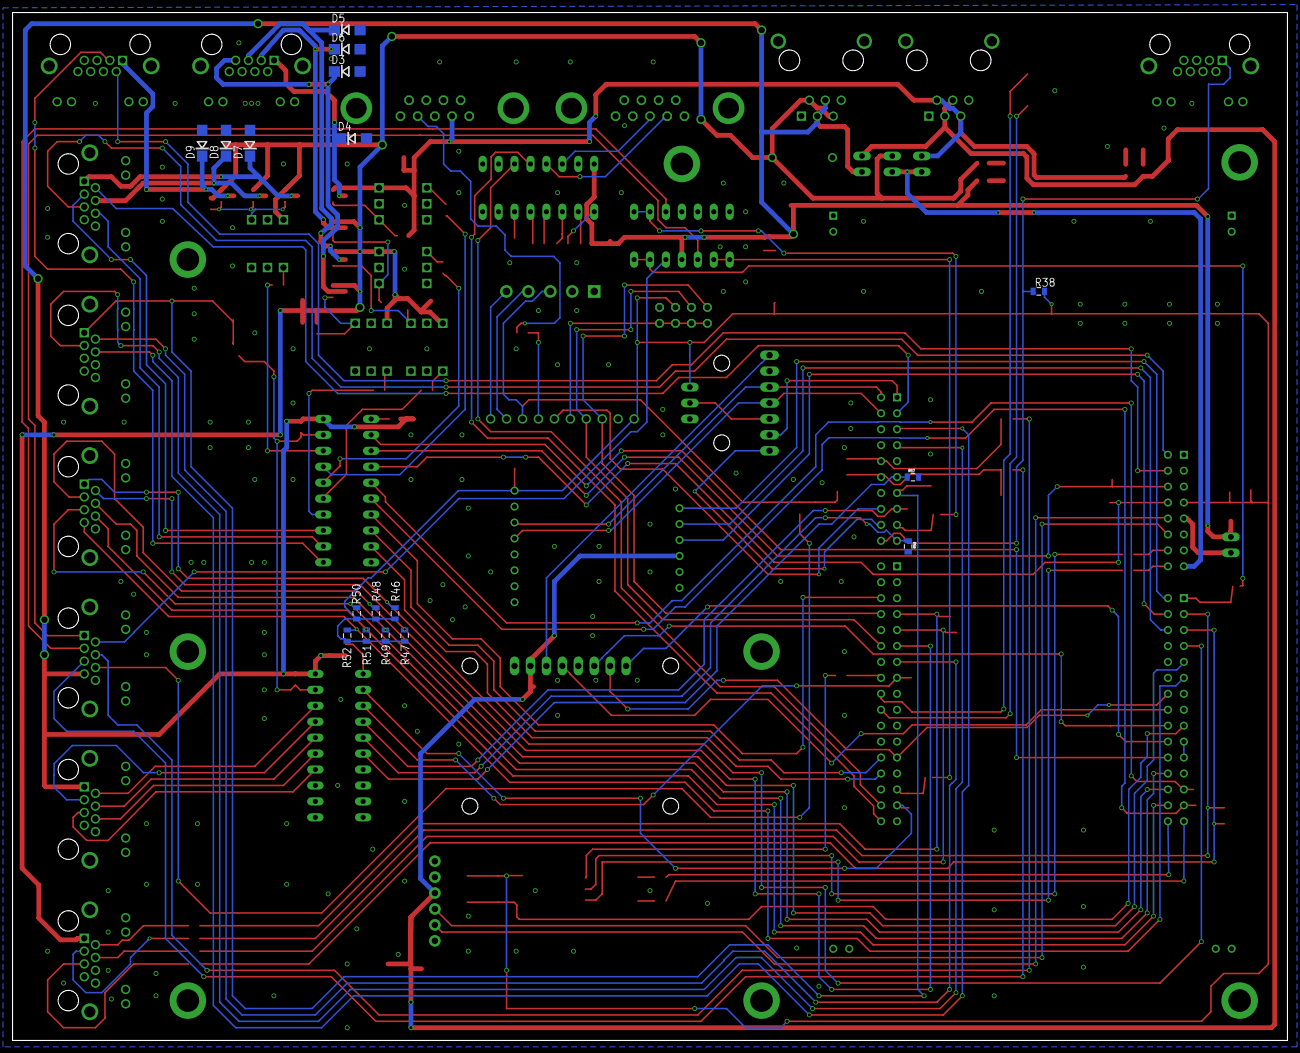
[picture p12: board Fuel_Cell_Controller.brd from below]

Board: 4 copper layers, 203.2 x 163.8 mm, 164 parts (17 on the bottom side), 143 nets.
