UAlberta-EcoCar/Fuel-Cell-Controller-2017-2018/PullDownResistorShield.brd

## EAGLE design PullDownResistorShield.brd (2018-03-18)

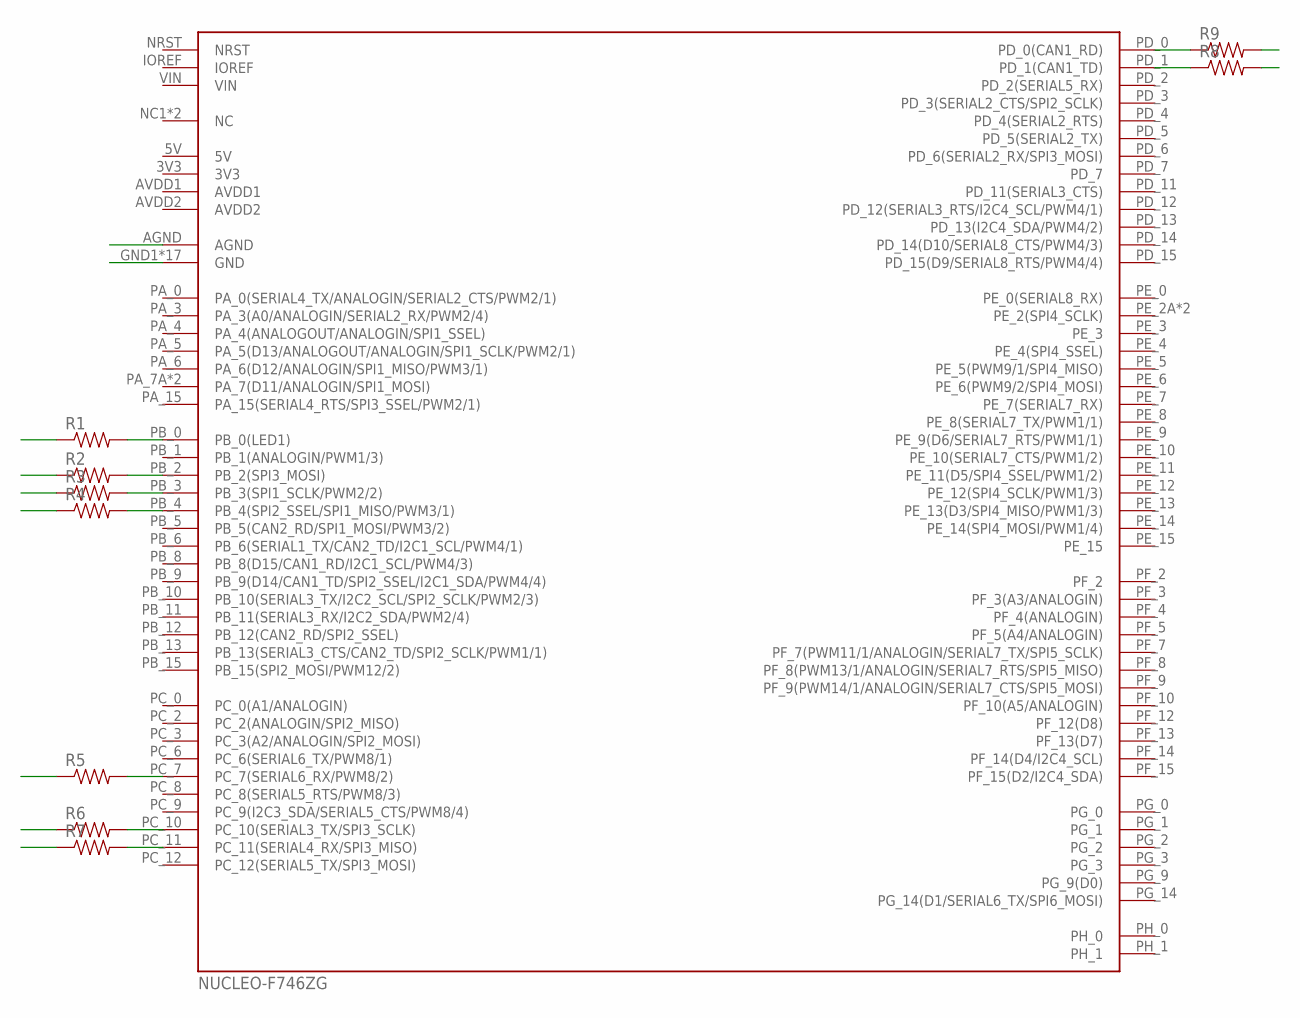
[picture p13: schematic PullDownResistorShield.sch]

Parts:
R1, R2, R3, R4, R5, R6, R7, R8, R9: RESISTORPTH-1/4W; AXIAL-0.4
U$1: NUCLEO-F746ZGNUCLEO-F746ZG; NUCLEO-F746ZG

Connections:
GND: R1.P$1 (1), R2.P$1 (1), R3.P$1 (1), R4.P$1 (1), R5.P$1 (1), R6.P$1 (1), R7.P$1 (1), R8.P$2 (2), R9.P$2 (2), U$1.AGND, U$1.GND1 (GND), U$1.GND2 (GND), U$1.GND3 (GND), U$1.GND4 (GND), U$1.GND5 (GND), U$1.GND6 (GND), U$1.GND7 (GND), U$1.GND8 (GND), U$1.GND9 (GND), U$1.GND10 (GND), U$1.GND11 (GND), U$1.GND12 (GND), U$1.GND13 (GND), U$1.GND14 (GND), U$1.GND15 (GND), U$1.GND16 (GND), U$1.GND17 (GND)
unnamed: R1.P$2 (2), U$1.PB_0 (PB_0(LED1))
unnamed: R2.P$2 (2), U$1.PB_2 (PB_2(SPI3_MOSI))
unnamed: R3.P$2 (2), U$1.PB_3 (PB_3(SPI1_SCLK/PWM2/2))
unnamed: R4.P$2 (2), U$1.PB_4 (PB_4(SPI2_SSEL/SPI1_MISO/PWM3/1))
unnamed: R5.P$2 (2), U$1.PC_7 (PC_7(SERIAL6_RX/PWM8/2))
unnamed: R6.P$2 (2), U$1.PC_10 (PC_10(SERIAL3_TX/SPI3_SCLK))
unnamed: R7.P$2 (2), U$1.PC_11 (PC_11(SERIAL4_RX/SPI3_MISO))
unnamed: R9.P$1 (1), U$1.PD_0 (PD_0(CAN1_RD))
unnamed: R8.P$1 (1), U$1.PD_1 (PD_1(CAN1_TD))

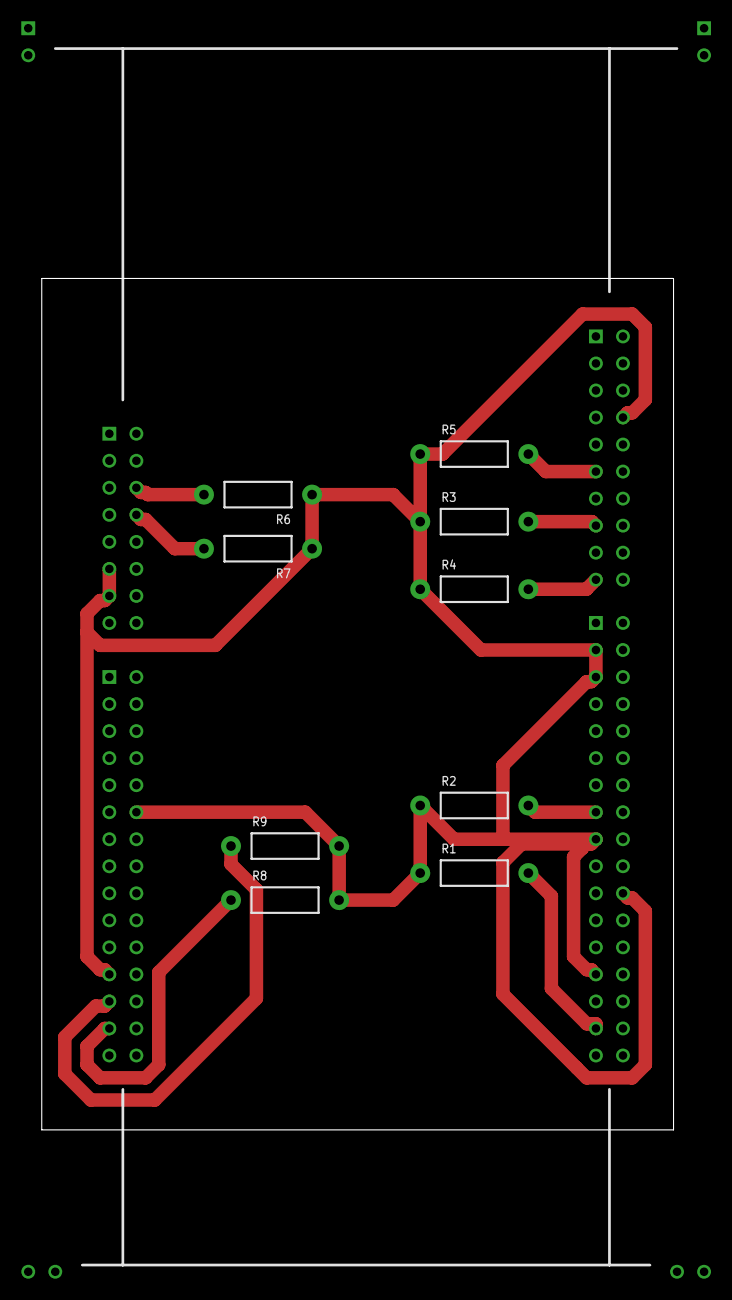
[picture p14: board PullDownResistorShield.brd from above]

Board: 2 copper layers, 59.4 x 80.0 mm, 10 parts (0 on the bottom side), 10 nets.
