UAlberta-EcoCar/Fuel-Cell-Controller-2017-2018/Themistor_Breakout.brd

## EAGLE design Themistor_Breakout.brd (2017-12-05)

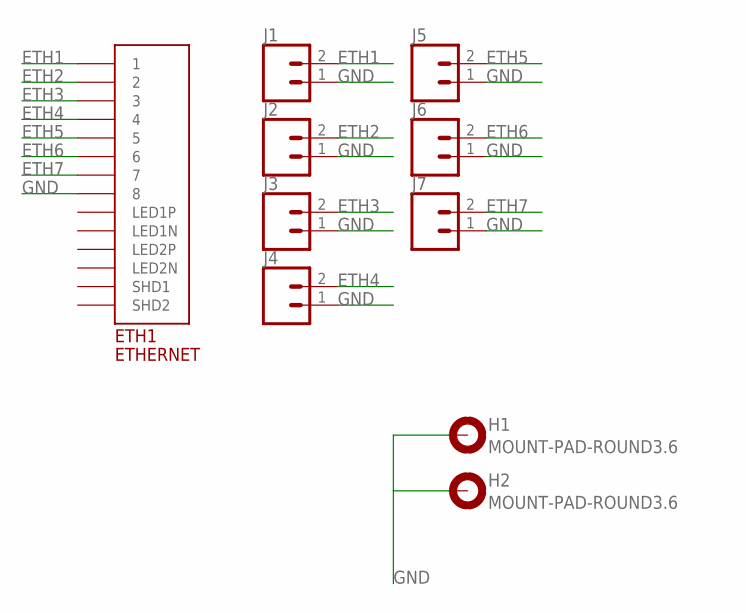
[picture p15: schematic Themistor_Breakout.sch]

Parts:
ETH1: ETHERNET; A122645-ND
H1, H2: MOUNT-PAD-ROUND3.6; 3,6-PAD
J1, J2, J3, J4, J5, J6, J7: CONN_023.5MM; SCREWTERMINAL-3.5MM-2

Connections:
ETH1: ETH1.P$1 (1), J1.2
ETH2: ETH1.P$2 (2), J2.2
ETH3: ETH1.P$3 (3), J3.2
ETH4: ETH1.P$4 (4), J4.2
ETH5: ETH1.P$5 (5), J5.2
ETH6: ETH1.P$6 (6), J6.2
ETH7: ETH1.P$7 (7), J7.2
GND: ETH1.P$8 (8), H1.B3,6, H2.B3,6, J1.1, J2.1, J3.1, J4.1, J5.1, J6.1, J7.1

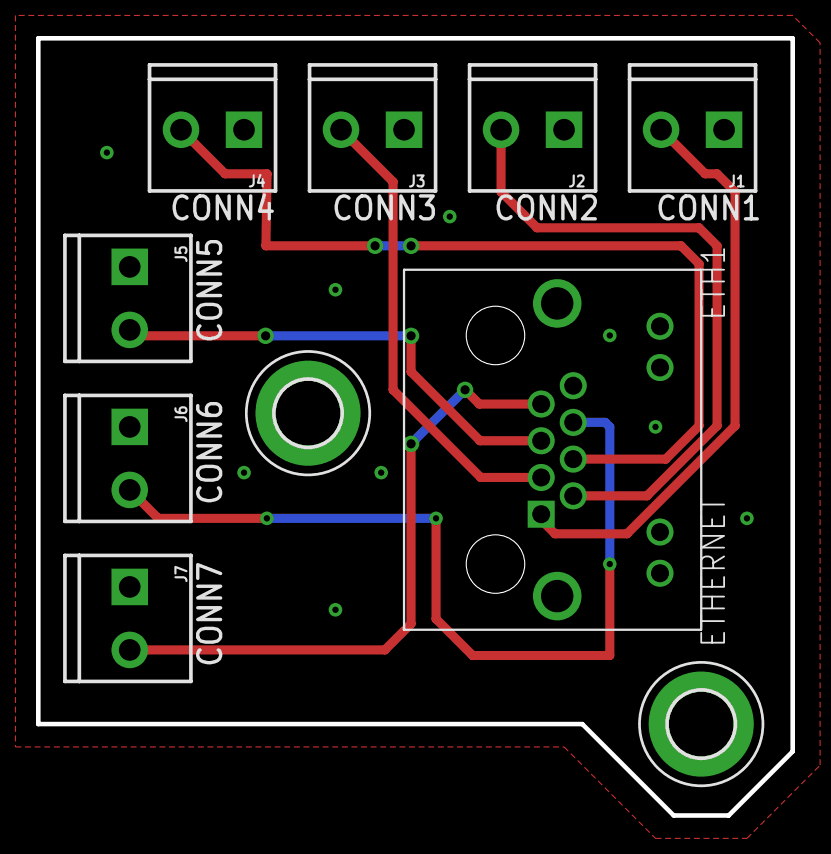
[picture p16: board Themistor_Breakout.brd from above]

Board: 2 copper layers, 41.9 x 43.2 mm, 10 parts (0 on the bottom side), 8 nets.
