UAlberta-EcoCar/Fuel-Cell-Controller-2017-2018/(commit log)

2017-10-04 Created Fuel Cell Controller Schematic
    [Fuel_Cell_Controller.sch]
2017-10-04 Added FCC_library that has three parts needed for board
    [Fuel_Cell_Controller.sch]
2017-10-07 Added some labels to Ethernet Connectors
    [Fuel_Cell_Controller.sch]
2017-10-07 Created RJ45 thermistor breakout board
    [Themistor_Breakout.brd, Themistor_Breakout.sch]
2017-10-12 Added a couple of connections and a part to library
    [Fuel_Cell_Controller.sch]
2017-10-12 Almost finished connection to OPENLOG. Not sure how reset pin works.
    [Fuel_Cell_Controller.sch]
2017-10-13 Finished Ethernet Conn Schematic
    [Fuel_Cell_Controller.sch]
2017-10-13 added a few more connections and set up reset pin
    [Fuel_Cell_Controller.sch]
2017-10-14 Finished Openlog. Reset will be controlled by microcontroller
    [Fuel_Cell_Controller.sch]
2017-10-14 Added Bluetooth
    [Fuel_Cell_Controller.sch]
2017-10-14 Removed stray gnd traces from autorouter
    [Themistor_Breakout.brd]
2017-10-14 Added mounting holes to thermistor breakout
    [Themistor_Breakout.brd, Themistor_Breakout.sch]
2017-10-14 Finished most serial connections
    [Fuel_Cell_Controller.sch]
2017-10-14 Added humidity sensor to parts library
2017-10-21 Started Fans Schematic
    [Fuel_Cell_Controller.sch]
2017-10-25 Implemented FTDI Chip on the schematic
    [Fuel_Cell_Controller.sch]
2017-10-28 added some connections
    [Fuel_Cell_Controller.sch]
2017-10-28 added a few connections
    [Fuel_Cell_Controller.sch]
2017-10-28 added some buffers
    [Fuel_Cell_Controller.sch]
2017-10-28 buffer changes
    [Fuel_Cell_Controller.sch]
2017-10-28 Added humidity sensor
    [Fuel_Cell_Controller.sch]
2017-10-28 Didn't really do anything
    [Fuel_Cell_Controller.sch]
2017-10-28 Created new sheets for Valves, Fans, FC LP Filter
    [Fuel_Cell_Controller.sch]
2017-10-30 Added photocouplers
    [Fuel_Cell_Controller.sch]
2017-10-30 Added rs232 to mass flow meter
    [Fuel_Cell_Controller.sch]
2017-10-31 Added DS3231 RTC
    [Fuel_Cell_Controller.sch]
2017-10-31 Made it look prettier
    [Fuel_Cell_Controller.sch]
2017-11-04 Added the ADC into the library
2017-11-04 Added ADC to schematic
    [Fuel_Cell_Controller.sch]
2017-11-05 Added value for capacitor between 3v3 and gnd on rtc
    [Fuel_Cell_Controller.sch]
2017-11-06 Working on routing now. Deleted caps and resistors on RTC
    [Fuel_Cell_Controller.brd, Fuel_Cell_Controller.sch]
2017-11-06 lol kk
    [Fuel_Cell_Controller.brd, Fuel_Cell_Controller.sch]
2017-11-07 Added a couple of indicator LEDs
    [Fuel_Cell_Controller.brd, Fuel_Cell_Controller.sch]
2017-11-07 Added TLV2404 Op-amp part (with Dil14 package)
    [Fuel_Cell_Controller.brd, Fuel_Cell_Controller.sch]
2017-11-07 Changed resistors and caps to 0805; need to spec out some decoupling capacitors, add LED's, and complete low-pass filter with op-amp
    [Fuel_Cell_Controller.brd, Fuel_Cell_Controller.sch]
2017-11-07 Added a few notes to schematic
    [Fuel_Cell_Controller.sch]
2017-11-08 Added a couple indicator LED's and speced out parts on digikey. Added connections to NUCLEO. Will create a part for the RGB LED next and implement it
    [Fuel_Cell_Controller.brd, Fuel_Cell_Controller.sch]
2017-11-08 Added the 5060BRG4 RGB LED to the library
2017-11-08 Implemented all indicator LED's, including the RGB one
    [Fuel_Cell_Controller.brd, Fuel_Cell_Controller.sch]
2017-11-09 Added another screw terminal and voltage division for mass flow meter and connected it to the external ADC
    [Fuel_Cell_Controller.brd, Fuel_Cell_Controller.sch]
2017-11-09 Added extra backup rs232 port
    [Fuel_Cell_Controller.brd, Fuel_Cell_Controller.sch]
2017-11-09 Changed the values and number of decoupling capacitors
    [Fuel_Cell_Controller.brd, Fuel_Cell_Controller.sch]
2017-11-09 Added push button
    [Fuel_Cell_Controller.brd, Fuel_Cell_Controller.sch]
2017-11-09 Added electrolytic decoupling capacitors and start signal
    [Fuel_Cell_Controller.brd, Fuel_Cell_Controller.sch]
2017-11-09 Implemented op amp for low-pass filter
    [Fuel_Cell_Controller.brd, Fuel_Cell_Controller.sch]
2017-11-11 made unneccessary backup
    [Fuel_Cell_Controller.brd, Fuel_Cell_Controller.sch]
2017-11-11 Added starter relay and did more board layout
    [Fuel_Cell_Controller.brd, Fuel_Cell_Controller.sch]
2017-11-13 Added display, fixed power supplies
    [Fuel_Cell_Controller.brd, Fuel_Cell_Controller.sch]
2017-11-13 Started routing
    [Fuel_Cell_Controller.brd, Fuel_Cell_Controller.sch]
2017-11-13 Continued routing
    [Fuel_Cell_Controller.brd, Fuel_Cell_Controller.sch]
2017-11-14 Labelled RJ45 Connectors
    [Fuel_Cell_Controller.brd, Fuel_Cell_Controller.sch]
2017-11-14 Added PWR indicator LEDS
    [Fuel_Cell_Controller.brd, Fuel_Cell_Controller.sch]
2017-11-14 Deleted Start Screw Terminal
    [Fuel_Cell_Controller.brd, Fuel_Cell_Controller.sch]
2017-11-15 Added some changes in the Schematic to the Board
    [Fuel_Cell_Controller.brd, Fuel_Cell_Controller.sch]
2017-11-17 Continued Routing the FCC Board
    [Fuel_Cell_Controller.brd]
2017-11-20 Routing complete! Need to check the two airwires between nucleo pins
    [Fuel_Cell_Controller.brd, Fuel_Cell_Controller.sch]
2017-11-24 Some Updates
    [Fuel_Cell_Controller.brd, Fuel_Cell_Controller.sch]
2017-11-25 Started Cleaning up the Silk Screen
    [Fuel_Cell_Controller.brd, Fuel_Cell_Controller.sch]
2017-11-26 Deleted extra rs232 and added a capacitor to the ESTOP signal
    [Fuel_Cell_Controller.brd, Fuel_Cell_Controller.sch]
2017-11-27 Moved capacitor on estop
    [Fuel_Cell_Controller.brd, Fuel_Cell_Controller.sch]
2017-11-28 Switched P Mosfet with a n mosfet
    [Fuel_Cell_Controller.brd, Fuel_Cell_Controller.sch]
2017-11-30 Adjusted how nucleo was powered and adding voltage dividers to pressure sensors
    [Fuel_Cell_Controller.brd, Fuel_Cell_Controller.sch]
2017-11-30 Added pressure sensor voltage dividers to schematic
    [Fuel_Cell_Controller.brd, Fuel_Cell_Controller.sch]
2017-11-30 Added Pull Up resistors to thermistor inputs
    [Fuel_Cell_Controller.brd, Fuel_Cell_Controller.sch]
2017-11-30 ReRouted a few traces for resistors
    [Fuel_Cell_Controller.brd, Fuel_Cell_Controller.sch]
2017-11-30 Moved Schematic Around a Bit
    [Fuel_Cell_Controller.sch]
2017-12-02 Changed DSUB connector pinouts
    [Fuel_Cell_Controller.brd, Fuel_Cell_Controller.sch]
2017-12-05 Gerbers Generated
    [Fuel_Cell_Controller.brd]
2017-12-05 Remade thermistor breakout gerbers
    [Themistor_Breakout.brd]
2017-12-09 Added a few resistor values
    [Fuel_Cell_Controller.brd, Fuel_Cell_Controller.sch]
2017-12-31 fixed pin spacing on Nucleo part
2017-12-31 updated brd file with new nucleo part
    [2017-12-12T16_07_54.csv, Fuel_Cell_Controller.brd, Fuel_Cell_Controller.sch]
2017-12-31 fixed board routing
    [Fuel_Cell_Controller.brd]
2018-01-02 Generated Gerbers
2018-03-18 Pull down resistor shield
    [PullDownResistorShield.brd, PullDownResistorShield.sch]
2018-05-29 Made some changes to the FCC board: -Added pull down resistors -Added master power switch -Added power selector switch -Fixed PMOS circuits -Updated PMOS symbol -Decreased signal trace size
    [Fuel_Cell_Controller.brd, Fuel_Cell_Controller.sch]
2018-07-10 Changed wiring to mass flow meter, part pin numbering is wrong and needs to be changed, mass flow meter needs a serial cable without NULL-Terminal
    [Fuel_Cell_Controller.brd, Fuel_Cell_Controller.sch]
2018-07-12 Removed power switch, moved poer supply selector from slide switch to header short, moved cap_curr off nucleo and onto the external adc
    [Fuel_Cell_Controller.brd, Fuel_Cell_Controller.sch]
2018-07-14 updated rj 11 part
    [Fuel_Cell_Controller.brd, Fuel_Cell_Controller.sch]
